rmklakshan/High-Frequency-Amplifier/Enclosure/1.PNG

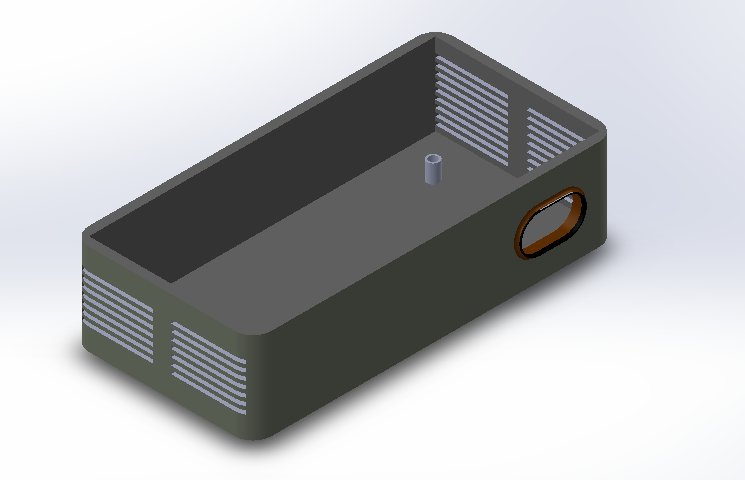
Enclosure/1.PNG
