rmklakshan/High-Frequency-Amplifier/Feasibility Report/Feasibility_Group20.pdf

Pre-Amplifier

In an amplifier, the ‘signal amplifier’ does the initial amplification and the removal of noises, while the ‘Power Amplifier’ provides the final amplification, which needs to connect a load. There were different kinds of preamplifier designs.

1.Pre-amplifier using BJT with common emitter configuration

This method is also simple and common. As the first step, we thought to work with this configuration and adjust the circuit according to the upcoming problems.

DC bias
The power supply is 12v and we have made the DC biasing point (Q point), such that VCE, Q is closer to 6v.

Amplification mode
First, we have selected a sinusoidal waveform of 0.1v (peak to peak) with an initial frequency of 1kHz. We have first, analyzed the circuit without a load.

Figure 2:- Vin, Ib, Ic, Vo

Effect of load value
After that, we have connected a load resistor of 2kohm.

We have observed the fact that the output voltage has slightly dropped.

Then we reduced the output resistance to 100 ohms and observed the output current.

Conclusion: - When the load resistance has reduced, the output voltage has also reduced. We cannot expect this behavior, from a good amplifier.

Figure 1

Figure 3: - Vo (Ro =2k, f=1kHz)

Figure 4: - Vo (Ro = 200ohm, f= 1kHz)

INPUT | Pre Amplifier
INPUT | Power Amplifier

### High Frequency Amplifier - Project Feasibility Report

Effect of frequency
Then we have checked the effect of the frequency, by keeping the load of 200ohm and increasing the input frequency up to 1000kHz.

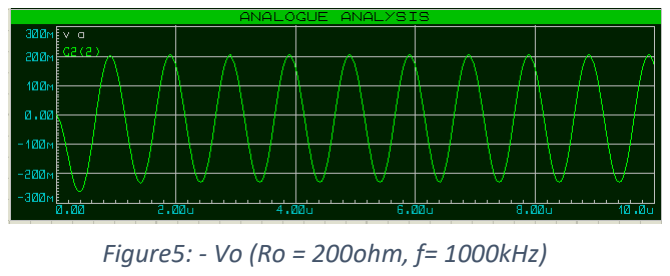
[picture p10: figure]
Figure5: - Vo (Ro = 200ohm, f= 1000kHz)
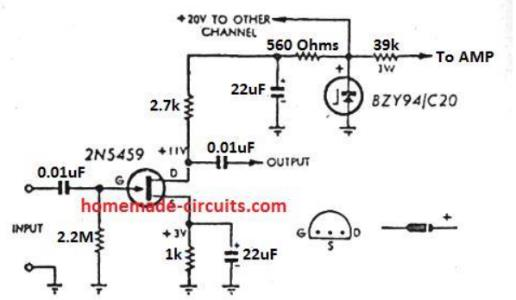
[picture p11: figure]

Conclusion: - When increasing the input frequency, the output voltage reduces (But the effect of frequency change is less than the effect of the change of load). A good amplifier should not have this behavior.

2.Pre-amplifier using 2 BJT transistors (Alternative method)
This is a simple, yet very useful pre-amplifier circuit. It draws little current from the load, due to its high input impedance. We hope to implement this, check its limits, and do the necessary changes to the circuit.
This pre-amplifier is said to be working properly, above the 3dB merging, in between the 20Hz to 200kHz.

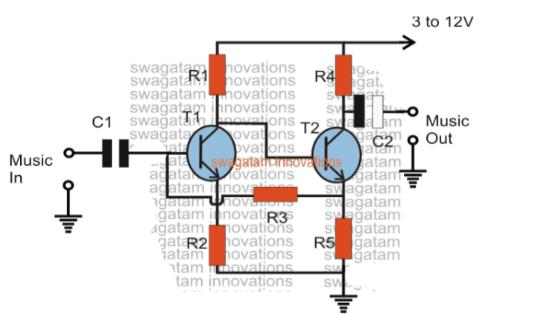
[picture p12: figure]

3.Pre-amplifier using FET
(Alternative method)

This circuit can be implemented with only one JFET transistor. Therefore, this is much simpler than the previous model.

Final Conclusion (Preamplifier): -

We will need another amplification part to supply the corresponding current to the load and, keep the output voltage unchanged, even during a change of the load.

Power-Amplifier

This sort of amplification is using to amplify the power. This power will suit for resistance between 8 ohms and higher values. When we use Push pull amplifier output signal won’t get reduce its amplitude. Here one transistor is sinking current from the load to ground (or negative power supply) while the other transistor is supplying current to the load.

In push pull amplifier there are two outputs which are work in phase difference of 180⁰
.These two
antiphase output signals are connected to load to add those output signals. But considering distortion parts of signals get subtracted due to their non-linearity. We can reduce distortion signals taking much similar non-linearity devices.

Mostly npn and pnp both types are using to design
push | pull | amplification | circuits. | Which
transistors to use for our project has to decide in future as we intend to select them depend on our stage 1 output. For now our intention is to use 4 transistors (2 pnp and 2npn transistors)

Figure 6

Figure 7

Alternatives

Using Op Amps

The circuit can be designed to convert the differential output current of an audio AC-DC converter into a single ended voltage capable of driving low impedance headphones. Two Op Amps are used as transimpedance amplifier which convert the DAC output current to a differential voltage. A difference amplifier then converts the differential voltage to single ended. A high power, high fidelity two channel audio Op Amp can be used in the difference amplifier to directly drive headphone loads.

Drawbacks

1. They do not response in the same way in lower and higher frequencies.
2. Op amps need to have a symmetric power supply.
3. Not much suitable for working with high powers.
4. Commercial amplifiers may shut off when load resistance is below specific level.
5. More cost than transistors

Transformer coupled class A amplifier circuit

A transformer can be used to improves the efficiency of the amplifier by matching the impedance of the load with that of the amplifier output impedance.

Drawbacks

1. More cost
2. Size of the audio amplifier is large
3. Any back emf generated may damage the transistor

Timeline

1. Analysis | Already done
2.Preliminary Design | 1 week
3.Detailed Design | 2 weeks
4.Simulation | parallel with 3
5.Prototyping | 2 weeks
6.Testing | parallel with 5
7.Rework | 1 week
8.Final working prototype | 1 week

References

1.Understanding, Calculating, and Measuring Total Harmonic Distortion

https://www.allaboutcircuits.com/technicalarticles/the-importance-of-total-harmonicdistortion/ (https://www.allaboutcircuits.com/technical-articles/the-importance-of-total-harmonic-distortion/)

2. Amplifier Classes

https://www.electronicstutorials.ws/amplifier/amplifier-classes.html (https://www.electronics-tutorials.ws/amplifier/amplifier-classes.html)

3.Data sheets.
