rmklakshan/High-Frequency-Amplifier/Enclosure/2.PNG

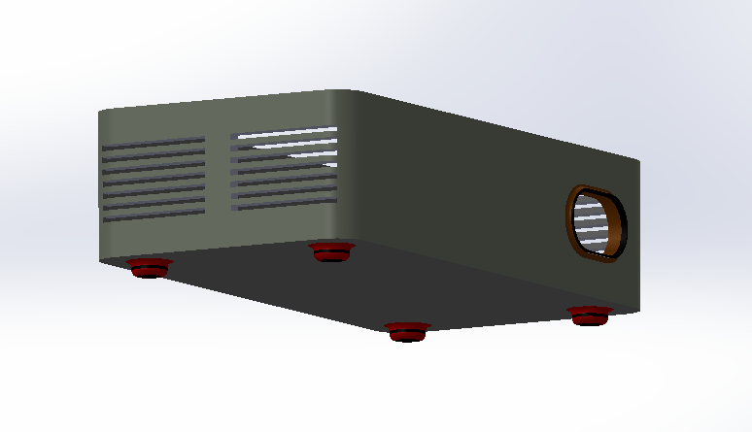
Enclosure/2.PNG
