rmklakshan/High-Frequency-Amplifier/Enclosure/3.PNG

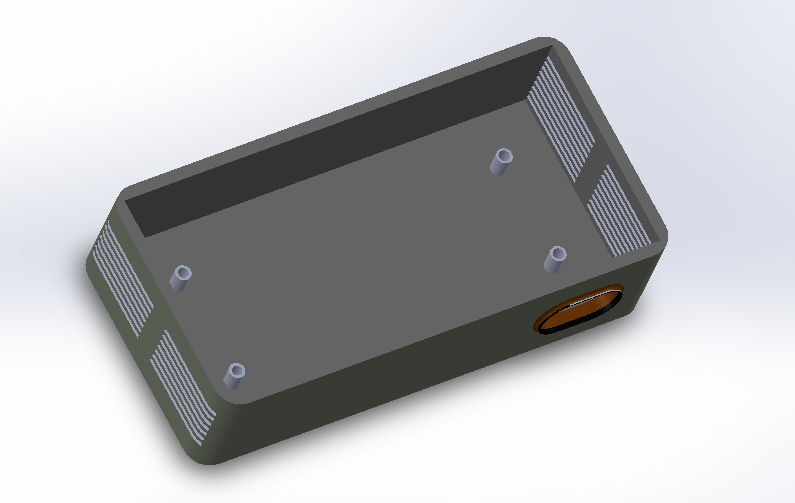
Enclosure/3.PNG
