rmklakshan/High-Frequency-Amplifier/Enclosure/4.PNG

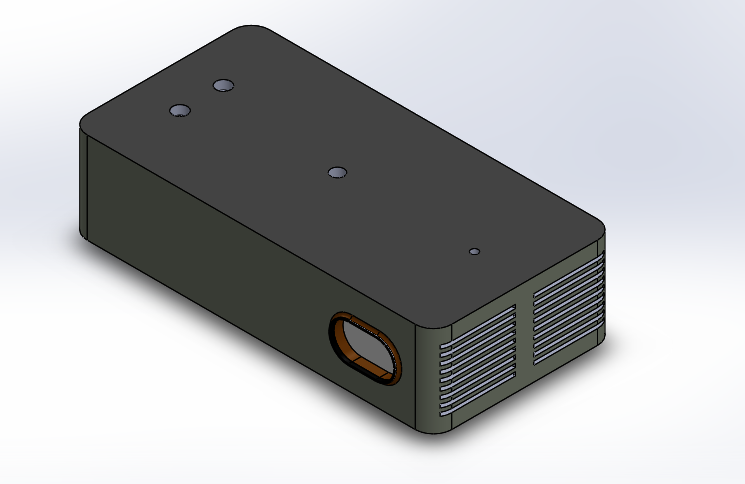
Enclosure/4.PNG
