rmklakshan/High-Frequency-Amplifier/Enclosure/Part1.SLDPRT

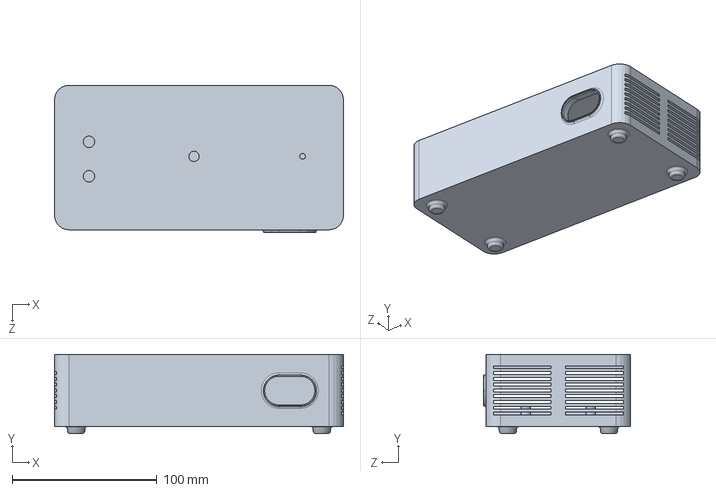
[picture p32: CAD file, 2022-10-31]
Enclosure/Part1.SLDPRT
200.0 x 55.0 x 102.0 mm
