rmklakshan/High-Frequency-Amplifier/(list of files, drawings)

Other design files:
Final_Design/New folder/3_24/3_24/Test 1/New Project.pdsprj
Final_Design/New folder/Intermediate/Intermediate/Intermediate.pdsprj
Final_Design/New folder/push pull.pdsprj/ROOT.DSN
Final_Design/New folder/push pull.pdsprj/ROOT.pdsprj
Final_Design/New Project.pdsprj
MUltisim/Design1.ms14
